lukewaite/panasonic-intellibalance-esphome/pcb.jpg

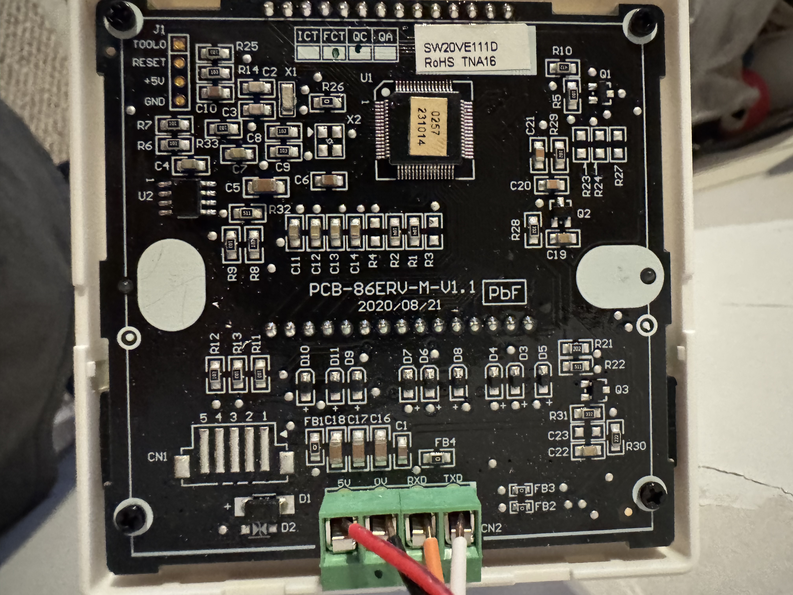
pcb.jpg
