lukewaite/panasonic-intellibalance-esphome/README.md

# Panasonic Intelli-Balance 200 ↔ ESPHome

Home Assistant control of a **Panasonic Intelli-Balance 200 ERV**, in the spirit of ratgdo. A small
ESP32-C6 board sits inline on the 4-wire cable between the ERV and its FV-SW20VEC1 wall control and
runs ESPHome over Thread. The wall control keeps working as before.

What it does:

- **Shows** power, airflow, ASHRAE setting, boost, the ventilation rest cycle, and inside/outside
  temperature and humidity.
- **Controls** power, a 60 min boost, supply/exhaust airflow and the ASHRAE run time.
- **Turns the ERV back on after a power failure**, which the ERV doesn't do by itself.
- **Fails safe:** unpowered or crashed, the board passes the link straight through.

## Install

A device config only names the device and sets up its network; the package brings in the rest:

```yaml
substitutions:
  name: ervlink
  friendly_name: ERV link
packages:
  ervlink: github://lukewaite/panasonic-intellibalance-esphome/firmware/ervlink-package.yaml@main
esphome:
  name: ${name}
  friendly_name: ${friendly_name}
api:
  encryption:
    key: !secret ervlink_api_key
wifi:                       # or Thread: see firmware/ervlink.yaml
  ssid: !secret wifi_ssid
  password: !secret wifi_password
```

`@main` follows the latest release (ESPHome refreshes it daily, and `main` always loads the
core at its latest release tag). To stay on one version, use a tag instead: `@fw-v16`.

## What's here

| | |
|---|---|
| [`firmware/ervlink-package.yaml`](firmware/ervlink-package.yaml) | The ESPHome package: the whole board, pulled in by a short device config. |
| [`firmware/ervlink.yaml`](firmware/ervlink.yaml), [`example-wifi.yaml`](firmware/example-wifi.yaml) | Device configs for Thread or Wi-Fi. Paste one into the ESPHome Device Builder, set the name and secrets. |
| [`hardware/DESIGN.md`](hardware/DESIGN.md) | The board: how it works and why each part was chosen. |
| [`hardware/kicad/`](hardware/kicad/) | KiCad project (generated by the scripts in `gen/`), with a [schematic PDF](hardware/kicad/ervlink-schematic.pdf) and JLCPCB gerbers, BOM and placement in [`fab/`](hardware/kicad/fab/). |
| [`hardware/bom-digikey.csv`](hardware/bom-digikey.csv) | The hand-soldered parts, enclosure and standoffs. |
| [`hardware/STATUS.md`](hardware/STATUS.md) | Build notes and a bring-up checklist. |
| [`docs/firmware.md`](docs/firmware.md) | How the board takes over the link, and how it resumes after a power cut. |
| [`docs/protocol.md`](docs/protocol.md) | How the ERV and wall control talk, and how to decode a capture. |
