lukewaite/panasonic-intellibalance-esphome/captures/TEMPLATE-notes.md

# Capture YYYY-MM-DD — <one-line purpose, e.g. "supply airflow staircase">

Copy this to `captures/YYYY-MM-DD/YYYY-MM-DD-notes.md` and fill it in *while capturing*.
The single most valuable thing here is the action log with real elapsed times.

## Sensor readings on the display at capture time

Press In/Out as needed to read all four. Record all of them even if the capture isn't about
sensors — these are what let us pin down register `B1`.

| | temp | humidity |
|---|---|---|
| Inside  |  °F |  %RH |
| Outside |  °F |  %RH |

Other displayed values: supply ___ cfm, exhaust ___ cfm, ASHRAE ___

## Unit state

- Unit on/off at start of capture:
- Was the ERV mains-power-cycled for this capture? (not required — see README):
- Boost active:

## Action log

Elapsed seconds from the start of the Saleae recording. **Do not estimate by counting in your
head** — watch the Saleae timer or a stopwatch started with the recording. The first capture's
notes were off by ~4 s, which cost real effort to reconcile.

| t (s) | action | display after |
|---|---|---|
|  |  |  |
|  |  |  |
|  |  |  |
|  |  |  |
|  |  |  |

## Capture settings used

- Analog sample rate:
- Channels (which probe on which wire):
- Duration:

## Notes / anything unexpected
