lukewaite/panasonic-intellibalance-esphome/captures/2026-10-29/2026-10-29-notes.md

# Capture 2026-10-29 — button session through the rev A board (listen-only firmware)

No Saleae recording. The rev A board decoded both lines live (firmware v2, 0 bad frames) and
Home Assistant's recorder logged every register change with millisecond timestamps
(`sensor.erv_link_rxd_*` / `sensor.erv_link_txd_*`, ~10 days retention). Times below are local
(EDT) wall clock from that history; the operator reported each step in chat as it was done.
Values are raw register strings as sent (low nibble first, see docs/protocol.md "Registers").

## Sensor readings on the display

| time | outside | `B1` |
|---|---|---|
| 21:47 (photo) | 59 °F / 75 %RH | `3103F0B4` → in 19 °C 48 %, out 15 °C 75 % |
| 22:11 | 57 °F / 76 %RH | `3103E0C4` → in 19 °C 48 %, out 14 °C 76 % |

Inside, via In/Out, read later that evening: 66 °F / 48 %RH, with `B1` inside bytes 19 °C / 48 %.
Airflow menu steps are 20 CFM (60–200); ASHRAE steps are 10 min/h.

Other displayed values at start: supply 120 cfm, exhaust 120 cfm, ASHRAE 30 min/h.

## Unit state

- On at start, no boost. No mains power cycle.

## Action log

| time | action | RXD command(s) | TXD state change |
|---|---|---|---|
| 22:08:38 | supply 120 → 140 | `00` `FF90FF00`, then `FFFF7000` | `01` `10707000` → `10907000` |
| 22:09:36 | supply 140 → 120 | `00` `FF70FF00` | `01` → `10707000` |
| 22:09:41 | exhaust 120 → 140 | `00` `FFFF9000` | `01` → `10709000` |
| 22:10:23 | exhaust 140 → 120 | `00` `FF70FF00`, then `FFFF7000` | `01` → `10707000` |
| 22:10:50 | Boost; display "Boost on 60m", then 200/200 cfm | `00` `10FFFF00`, `10` `30600000`, `20` `10000000` | `01` → `10010100`, `11` → `30600000`, `21` → `10000000` |
| ~22:11:40 | (display counting down, 59m) | — | no change |
| 22:12:11 | Boost cancelled; back to 120/120 | `00` `10707000`, `10` `30600000`, `20` `00000000` | `01` → `10707000`, `11` → `30000000`, `21` → `00000000` |
| ~22:12:50 | Vent pressed (opens airflow editor, supply flashing) | — | — |
| 22:13:30 | supply → 200 (max), exhaust unchanged | `00` `FF01FF00`, then `FFFF7000` | `01` → `10017000` |
| 22:14:09 | supply 200 → 180 (one step down) | `00` `FFD0FF00`, `FFD07000`, `FFFF7000` | `01` → `10D07000` |
| 22:14:49 | ASHRAE 30 → 10 | `10` `10FF0000` | `11` → `10000000` |
| 22:15:25 | supply 180 → 120 | (not pulled) | `01` → `10707000` |
| 22:15:33 | ASHRAE 10 → 30 | (not pulled) | `11` → `30000000` |
| 22:15:51 | OFF; display shows only outside temp/RH | `00` `00707000`, `10` `30FF0000`, `20` `00000000` | `01` → `00000000`, `11` → `00000000` |
| 22:16:29 | ON; 120/120, ASHRAE 30 | `00` `10707000`, `10` `30FF0000`, `20` `00000000` | `01` → `10707000`, `11` → `30000000` |
| ~22:17 | Filter, short press; no visible change | — | — |
| 22:18:21 | supply 120 → 60 (menu minimum), one save | `00` `FF10FF00` | `01` → `10107000` |
| ~22:19 | supply 60 → 120 | | |
| 22:36:22 | Boost, 60 m, left to time out | `00` `10FFFF00`, `10` `30600000`, `20` `10000000` | `01` → `10010100`, `11` → `30600000`, `21` → `10000000` |
| 23:36:24 | Boost timed out (60 min 2 s); display back to 120/120 | **none** | `11` → `30000000`, `21` → `00000000` (24.59), `01` → `10707000` (24.74) |

The timeout came entirely from the ERV: no RXD command, and the ERV restored the pre-boost
airflow itself. `30`, `F0`, `31`, `A1` and `F1` (`00003E00`) never changed. 0 bad frames, no unexpected
registers throughout.

## Capture settings used

- rev A board 1, SW1 not fitted (passthrough only), firmware `firmware/ervlink.yaml` v2.
