lukewaite/panasonic-intellibalance-esphome/captures/2026-11-02/2026-11-02-notes.md

# 2026-11-02 — power-failure resume (firmware v10)

No logic analyzer. Times from Home Assistant history (board on its own USB brick, so it stayed
up through the outage).

| time | event |
|---|---|
| ~19:16:29 | ERV mains off (user). Both frame rates fall to 0 by 19:16:39/44. v10 left Power, airflow etc. at their last values (fixed in v11). |
| ~19:18:02 | ERV mains back on. |
| 19:18:02.49 | First `01` from the ERV: off (Power switch off, airflow unknown). |
| 19:18:12.49 | Resume: relay in, ~10 s after the wall control's `FFFFFFFF` burst armed it. |
| 19:18:12.86 | ERV reports on at the saved settings (100/100 CFM), 0.37 s after relay in. |
| 19:18:13.50 | Relay out. |

Result: **the ERV turned itself back on ~10.4 s after mains returned**, first try, with the
pre-outage airflow.
