lukewaite/panasonic-intellibalance-esphome/captures/2026-10-30/2026-10-30-notes.md

# 2026-10-30 — first intercept and remote turn-on (firmware v5)

No Saleae recording. Times are local (EDT) from Home Assistant history. Board 1, SW1 in AUTO,
firmware `firmware/ervlink.yaml` v5. The ERV had been off since 08:43 (left off to test the
"ERV off for 10 minutes" notification, which fired at 08:53:26).

## Action log

| time | action | result |
|---|---|---|
| 10:01:56.316 | HA: **Intercept test** pressed | relay in 56.521 (205 ms after the press, in a shared gap), out 57.138 (617 ms in). Board forwarded the panel's idle frames for 3 cycles. ERV stayed off, wall control carried on as normal. |
| 10:02:08.321 | HA: **Turn on** pressed | relay in 08.528 (207 ms), TXD `01` `00000000` → `10707000` at 08.826 (298 ms after relay in, 505 ms after the press), relay out 09.541 (1.01 s in: 3 command + 2 idle cycles). Power on in HA, ERV running 120/120. |

Operator confirmed both: relay clicked, nothing disturbed on the test, ERV started on Turn on.

- The RXD tap is on the panel side, so `sensor.erv_link_rxd_00` stayed `FFFFFF00` throughout:
  the injected `10707000` is visible only in its effect on TXD `01`.
- The wall control picked the new state up from TXD with no command of its own; it is a pure
  display of `01`/`11`/`21`.
- The ERV applied the command 0.3 s after the first injected frame, as the panel's own presses
  (0.2–0.4 s).
- No analog capture of the board's drive levels was taken first; the ERV accepted the board's
  RXD drive (1k pull-up to ~4.7 V through Q2) as is.

## ASHRAE rest (firmware v6)

| time | action | result |
|---|---|---|
| 12:08:52.98 | HA: ASHRAE select 60 → 30 min/h | relay in, `11` → `30000000` at 53.55 (0.57 s), relay out 53.97 |
| 12:38:53.95 | (none) | `01` → `10EFEF00`: still on, supply and exhaust code `FE`. Exactly 30 min after the ASHRAE change: the rest half of the 30 min/h cycle. |
| 13:08:55.42 | (none) | `01` → `10707000`: air moving again, 30 min 1.5 s into the rest. v7's Ventilating went on at the same instant. |

v6 showed airflow as unknown during the rest; v7 shows 0 CFM, adds "Ventilating", and hides
B1 while resting.

## Boost switch (firmware v8)

| time | action | result |
|---|---|---|
| 20:38:21 | HA: Boost switch on (dashboard) | `01` supply 200 CFM and boost duration 60 at 21.79, `21` boost on at 21.89, relay out 22.43 |
| 21:38:24.71 | (none) | Boost over (60 min 3 s): switch off by itself, supply 120 at 24.88 |
| 22:08:26.22 | (none) | ASHRAE rest (0 CFM), 30 min after the boost ended |
| 22:38:27.71 | (none) | Air moving again; 30/30 cycle continues through the night |

First boost sent by the board. It was started 3 min into an ASHRAE rest (20:35:19): boost
overrides the rest, and **ending a boost restarts the ASHRAE cycle** with a full run period.
