lukewaite/panasonic-intellibalance-esphome/captures/2025-12-14/2025-12-14-notes.md

Approx timestamps (me counting in my head)
0s -> current state is ERV is off
5s power on to erv
10s push on/off on panel
15s stop capture

current values displayed
80 cfm supply
80 cfm exhaust
20 ashrae

outside humidity 85%RH 
outside temp 37F
