lukewaite/panasonic-intellibalance-esphome/hardware/bom-digikey.csv

Quantity per board | Manufacturer Part Number | Manufacturer | DigiKey Part Number | Reference | Description | Notes
1 | G6S-2 DC5 | Omron/Aratas | Z2615-ND | K1 | DPDT signal relay 5V THT 28mA | Matches the Relay_DPDT_Omron_G6S-2 footprint
1 | OS102011MS2QN1 | C&K | CKN9565-ND | SW1 | SPDT slide switch THT vertical | Must be MS2Q (vertical), not MA1Q (right-angle). Order by DigiKey number: the MPN matches two listings
2 | 1715747 | Phoenix Contact | 277-1265-ND | J1,J2 | 4-pos 5.08mm screw terminal (MKDS 1.5/4-5.08) | Generic 5.08mm KF128-style blocks also fit
0.2 | PRPC040SAAN-RC | Sullins | S1011EC-40-ND | J3 | 1x40 breakaway male header 2.54mm | One strip covers 5 boards (8 pins each)
1 | 1591CSBK | Hammond | HM104-ND | enclosure | ABS box 120x65x40 with lid | 1591CSGY is the grey version
5 | 25511 | Keystone | 36-25511-ND | H1-H5 | M3 x 12 mm nylon hex standoff female-female | 12 mm maximum (lid clearance); use M3 x 6-8 mm screws
