lukewaite/panasonic-intellibalance-esphome/hardware/kicad/fab/ervlink-bom.csv

Comment | Designator | Footprint | LCSC Part #
100k | R3,R4,R5,R10,R11,R17,R23 | R_0805_2012Metric | C149504
10µF | C5,C7,C9 | C_0805_2012Metric | C15850
USB-C | J4 | USB_C_Receptacle_HRO_TYPE-C-31-M-12 | C165948
100 | R2,R16,R22 | R_0805_2012Metric | C17408
10k | R9,R13,R15,R26,R27 | R_0805_2012Metric | C17414
12k | R7 | R_0805_2012Metric | C17444
1k | R1,R18,R30 | R_0805_2012Metric | C17513
2.2k | R24 | R_0805_2012Metric | C17520
220k | R8,R14 | R_0805_2012Metric | C17556
22k | R6 | R_0805_2012Metric | C17560
51k | R12 | R_0805_2012Metric | C17737
100pF | C1,C2 | C_0805_2012Metric | C1790
AO3400A | Q1,Q2,Q3 | SOT-23 | C20917
INTERCEPT | LED2 | LED_0805_2012Metric | C2296
POWER | LED1 | LED_0805_2012Metric | C2297
SS14 | D6 | D_SMA | C2480
5.1k | R28,R29 | R_0805_2012Metric | C27834
1µF | C4 | C_0805_2012Metric | C28323
22µF | C8 | C_0805_2012Metric | C45783
100nF | C3,C6 | C_0805_2012Metric | C49678
ESP32-C6-WROOM-1-N8 | U1 | ESP32-C6-WROOM-1 | C5366877
AMS1117-3.3 | U3 | SOT-223-3_TabPin2 | C6186
LM393DR2G | U2 | SOIC-8_3.9x4.9mm_P1.27mm | C7955
1N4148W | D1 | D_SOD-123 | C81598
