lukewaite/panasonic-intellibalance-esphome/hardware/kicad/ervlink-schematic.pdf

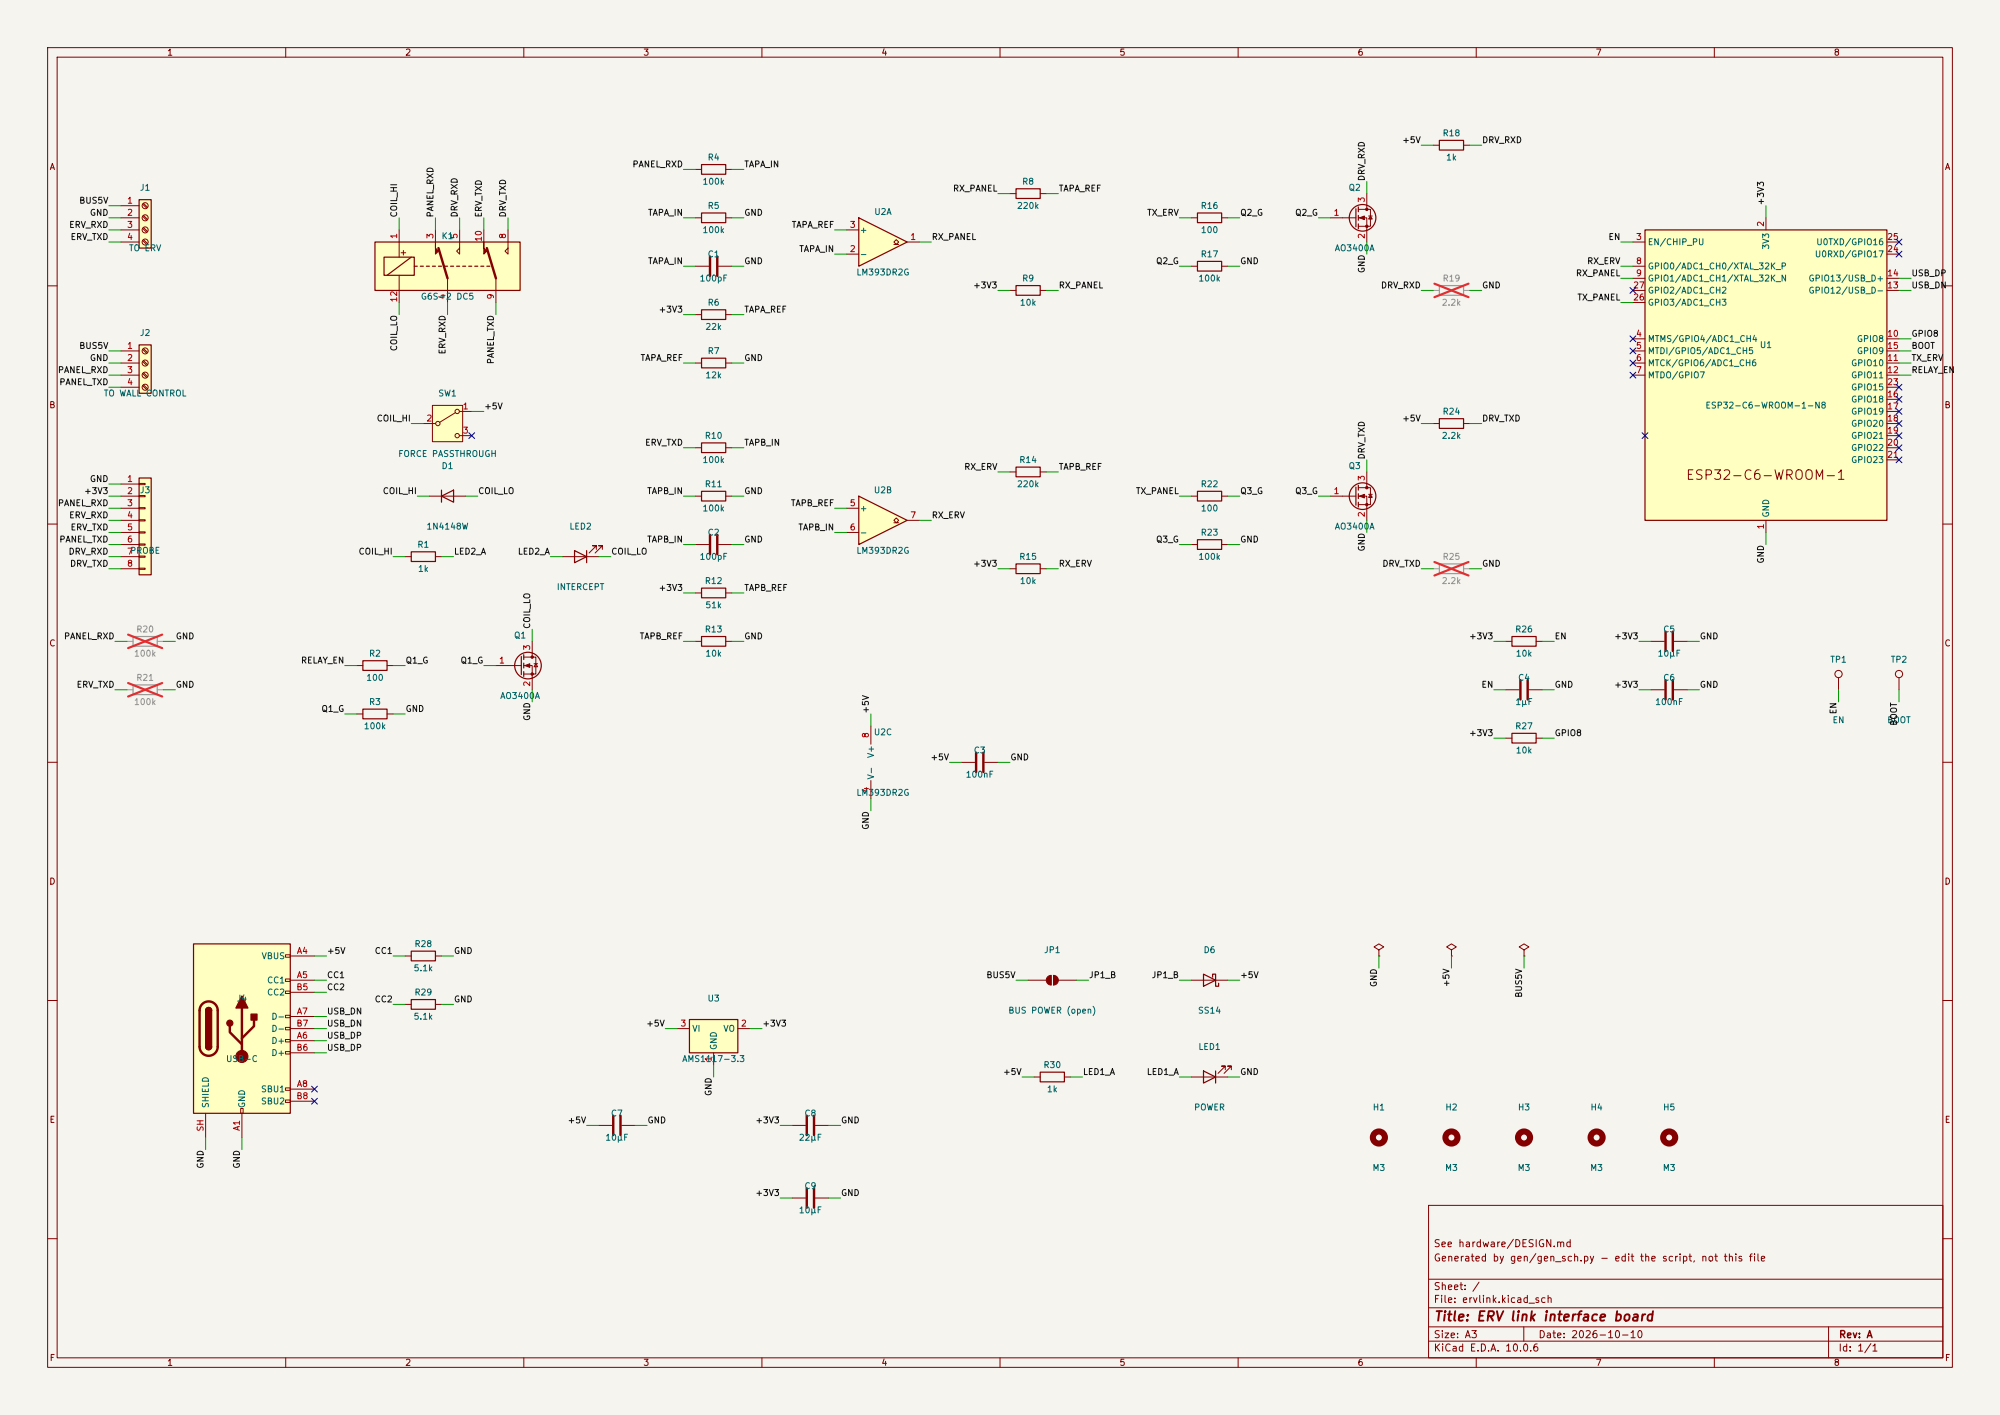
[picture p2: page 1]

See hardware/DESIGN.md
Generated by gen/gen_sch.py - edit the script, not this file

Sheet: /
File: ervlink.kicad_sch
Title: ERV link interface board

Size: A3 | Rev: A | F Date: 2026-10-10
KiCad E.D.A. 10.0.6 | Id: 1/1
