lukewaite/panasonic-intellibalance-esphome/hardware/kicad/ervlink.kicad_pcb

## KiCad design hardware/kicad/ervlink.kicad_pcb (2026-11-03)

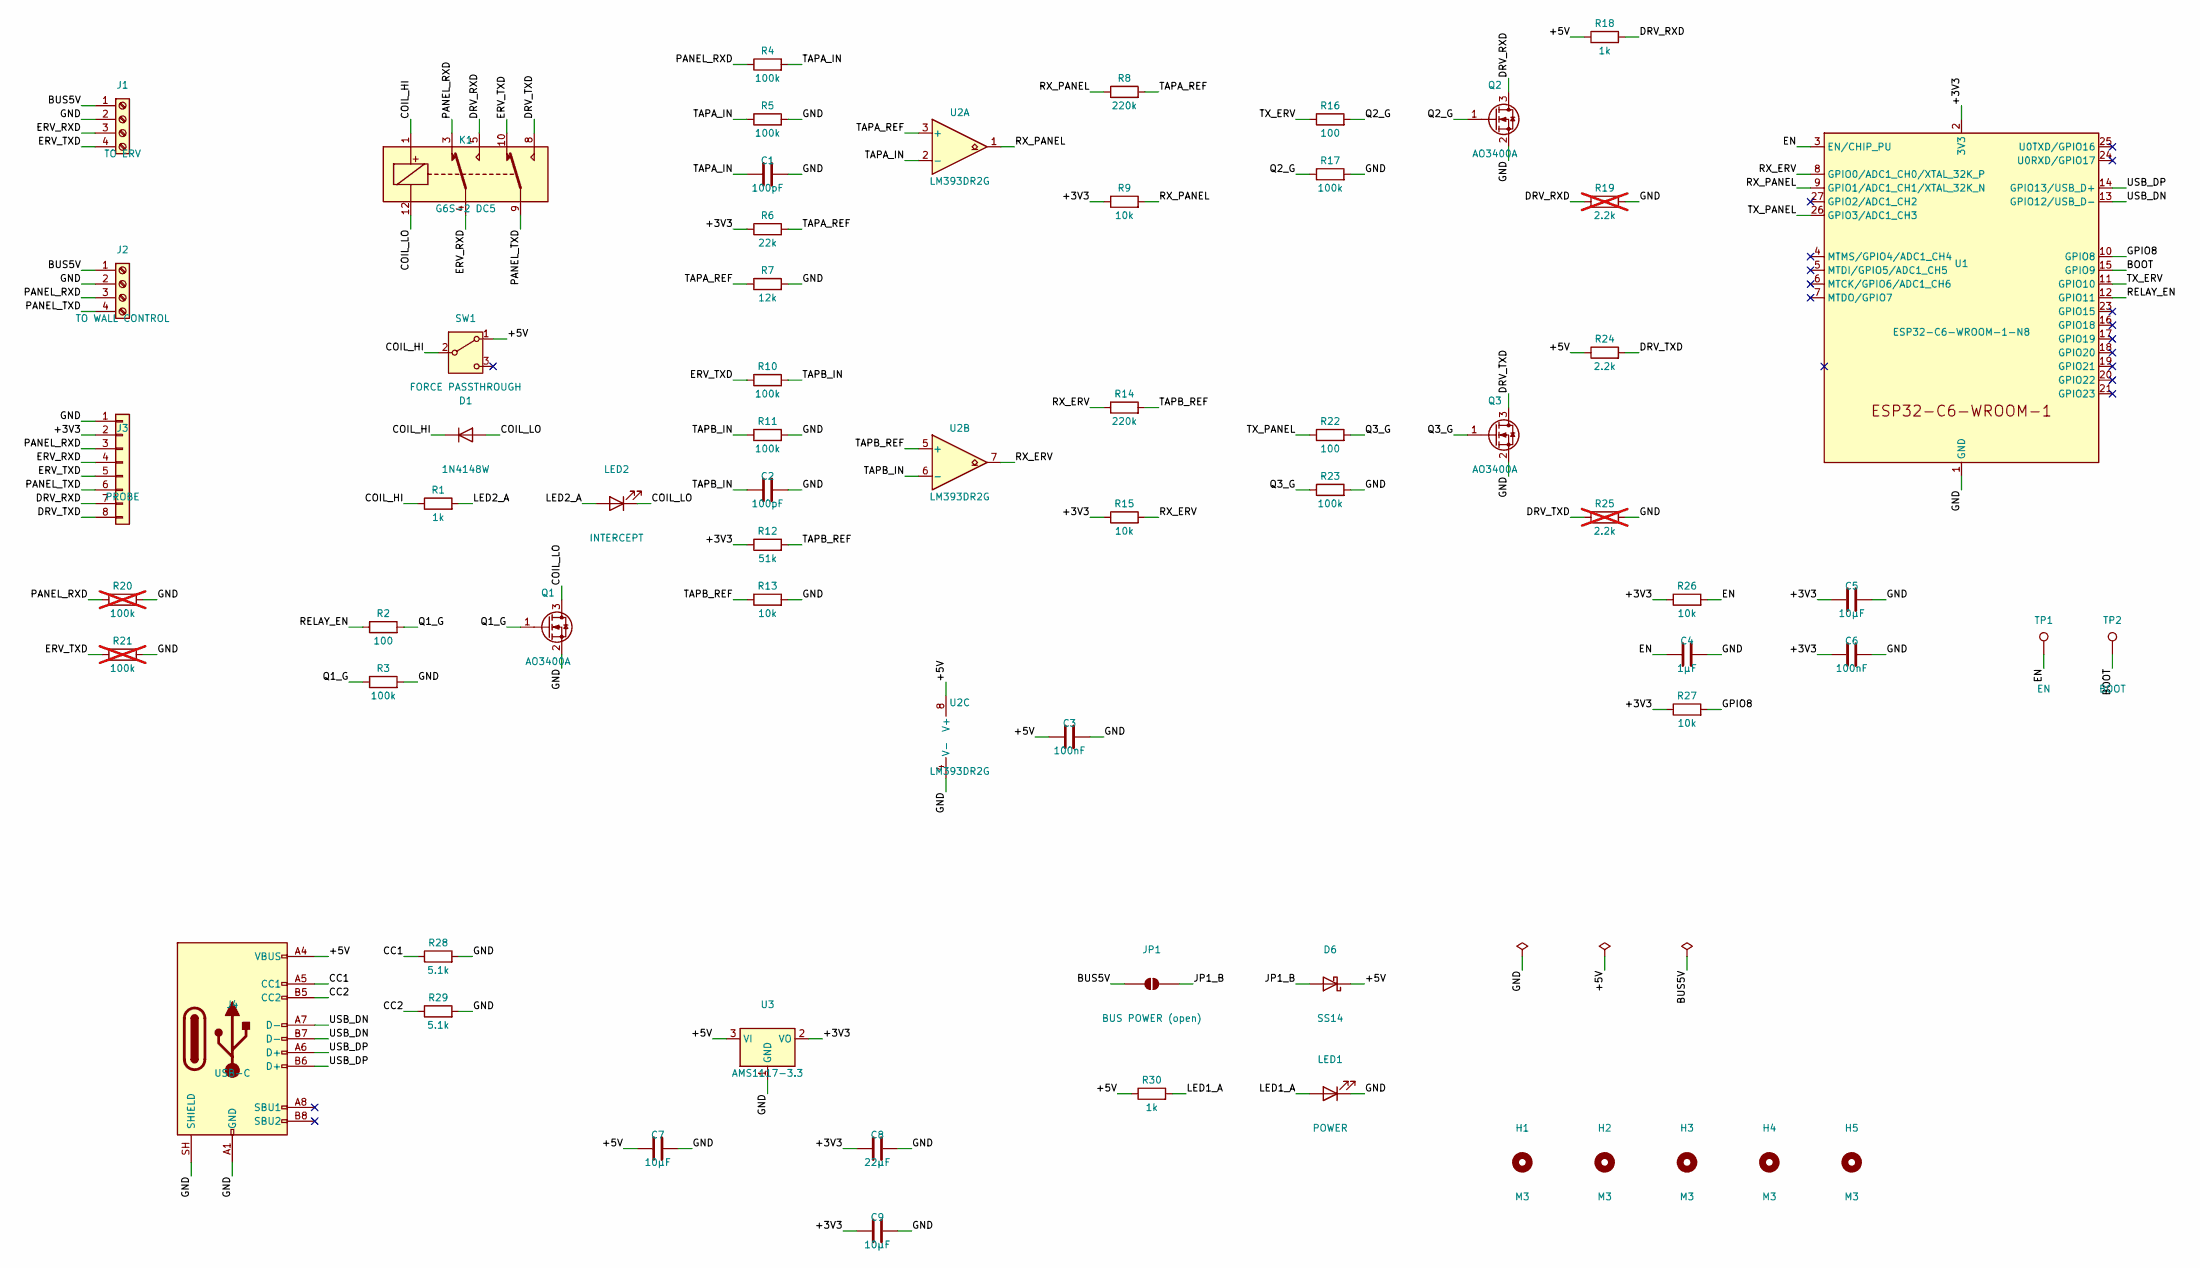
[picture p3: schematic ervlink.kicad_sch, ERV link interface board]

Parts:
C1, C2: 100pF; C_0805_2012Metric; LCSC C1790
C3, C6: 100nF; C_0805_2012Metric; LCSC C49678
C4: 1µF; C_0805_2012Metric; LCSC C28323
C5, C7, C9: 10µF; C_0805_2012Metric; LCSC C15850
C8: 22µF; C_0805_2012Metric; LCSC C45783
D1: 1N4148W; D_SOD-123; LCSC C81598
D6: SS14; D_SMA; LCSC C2480
H1, H2, H3, H4, H5: M3; MountingHole_3.2mm_M3
J1: TO ERV; TerminalBlock_Phoenix_MKDS-1,5-4-5.08_1x04_P5.08mm_Horizont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
J2: TO WALL CONTROL; TerminalBlock_Phoenix_MKDS-1,5-4-5.08_1x04_P5.08mm_Horizont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
J3: PROBE; PinHeader_1x08_P2.54mm_Vertical
J4: USB-C; USB_C_Receptacle_HRO_TYPE-C-31-M-12; LCSC C165948
JP1: BUS POWER (open); SolderJumper-2_P1.3mm_Open_RoundedPad1.0x1.5mm
K1: G6S-2 DC5; Relay_DPDT_Omron_G6S-2
LED1: POWER; LED_0805_2012Metric; LCSC C2297
LED2: INTERCEPT; LED_0805_2012Metric; LCSC C2296
Q1, Q2, Q3: AO3400A; SOT-23; LCSC C20917
R1, R18, R30: 1k; R_0805_2012Metric; LCSC C17513
R2, R16, R22: 100; R_0805_2012Metric; LCSC C17408
R3, R4, R5, R10, R11, R17, R23: 100k; R_0805_2012Metric; LCSC C149504
R6: 22k; R_0805_2012Metric; LCSC C17560
R7: 12k; R_0805_2012Metric; LCSC C17444
R8, R14: 220k; R_0805_2012Metric; LCSC C17556
R9, R13, R15, R26, R27: 10k; R_0805_2012Metric; LCSC C17414
R12: 51k; R_0805_2012Metric; LCSC C17737
R19, R25: 2.2k; R_0805_2012Metric; not fitted
R20, R21: 100k; R_0805_2012Metric; not fitted
R24: 2.2k; R_0805_2012Metric; LCSC C17520
R28, R29: 5.1k; R_0805_2012Metric; LCSC C27834
SW1: FORCE PASSTHROUGH; SW_Slide_SPDT_Straight_CK_OS102011MS2Q
TP1: EN; TestPoint_Pad_D1.5mm
TP2: BOOT; TestPoint_Pad_D1.5mm
U1: ESP32-C6-WROOM-1-N8; ESP32-C6-WROOM-1; LCSC C5366877
U2: LM393DR2G; SOIC-8_3.9x4.9mm_P1.27mm; LCSC C7955
U3: AMS1117-3.3; SOT-223-3_TabPin2; LCSC C6186

Connections:
/+3V3: C5.1, C6.1, C8.1, C9.1, J3.2, R6.1, R9.1, R12.1, R15.1, R26.1, R27.1, U1.2 (3V3), U3.2 (VO)
/+5V: C3.1, C7.1, D6.1 (K), J4.A4 (VBUS), J4.A9 (VBUS), J4.B4 (VBUS), J4.B9 (VBUS), R18.1, R24.1, R30.1, SW1.1 (A), U2.8 (V+), U3.3 (VI)
/BOOT: TP2.1, U1.15 (GPIO9)
/BUS5V: J1.1, J2.1, JP1.1 (A)
/CC1: J4.A5 (CC1), R28.1
/CC2: J4.B5 (CC2), R29.1
/COIL_HI: D1.1 (K), K1.1, R1.1, SW1.2 (B)
/COIL_LO: D1.2 (A), K1.12, LED2.1 (K), Q1.3 (D)
/DRV_RXD: J3.7, K1.5, Q2.3 (D), R18.2, R19.1
/DRV_TXD: J3.8, K1.8, Q3.3 (D), R24.2, R25.1
/EN: C4.1, R26.2, TP1.1, U1.3 (EN/CHIP_PU)
/ERV_RXD: J1.3, J3.4, K1.4
/ERV_TXD: J1.4, J3.5, K1.10, R10.1, R21.1
/GND: C1.2, C2.2, C3.2, C4.2, C5.2, C6.2, C7.2, C8.2, C9.2, J1.2, J2.2, J3.1, J4.A1 (GND), J4.A12 (GND), J4.B1 (GND), J4.B12 (GND), J4.SH (SHIELD), LED1.1 (K), Q1.2 (S), Q2.2 (S), Q3.2 (S), R3.2, R5.2, R7.2, R11.2, R13.2, R17.2, R19.2, R20.2, R21.2, R23.2, R25.2, R28.2, R29.2, U1.1 (GND), U1.28 (GND), U1.29 (GND), U2.4 (V-), U3.1 (GND)
/GPIO8: R27.2, U1.10 (GPIO8)
/JP1_B: D6.2 (A), JP1.2 (B)
/LED1_A: LED1.2 (A), R30.2
/LED2_A: LED2.2 (A), R1.2
/PANEL_RXD: J2.3, J3.3, K1.3, R4.1, R20.1
/PANEL_TXD: J2.4, J3.6, K1.9
/Q1_G: Q1.1 (G), R2.2, R3.1
/Q2_G: Q2.1 (G), R16.2, R17.1
/Q3_G: Q3.1 (G), R22.2, R23.1
/RELAY_EN: R2.1, U1.12 (GPIO11)
/RX_ERV: R14.1, R15.2, U1.8 (GPIO0/ADC1_CH0/XTAL_32K_P), U2.7
/RX_PANEL: R8.1, R9.2, U1.9 (GPIO1/ADC1_CH1/XTAL_32K_N), U2.1
/TAPA_IN: C1.1, R4.2, R5.1, U2.2 (-)
/TAPA_REF: R6.2, R7.1, R8.2, U2.3 (+)
/TAPB_IN: C2.1, R10.2, R11.1, U2.6 (-)
/TAPB_REF: R12.2, R13.1, R14.2, U2.5 (+)
/TX_ERV: R16.1, U1.11 (GPIO10)
/TX_PANEL: R22.1, U1.26 (GPIO3/ADC1_CH3)
/USB_DN: J4.A7 (D-), J4.B7 (D-), U1.13 (GPIO12/USB_D-)
/USB_DP: J4.A6 (D+), J4.B6 (D+), U1.14 (GPIO13/USB_D+)

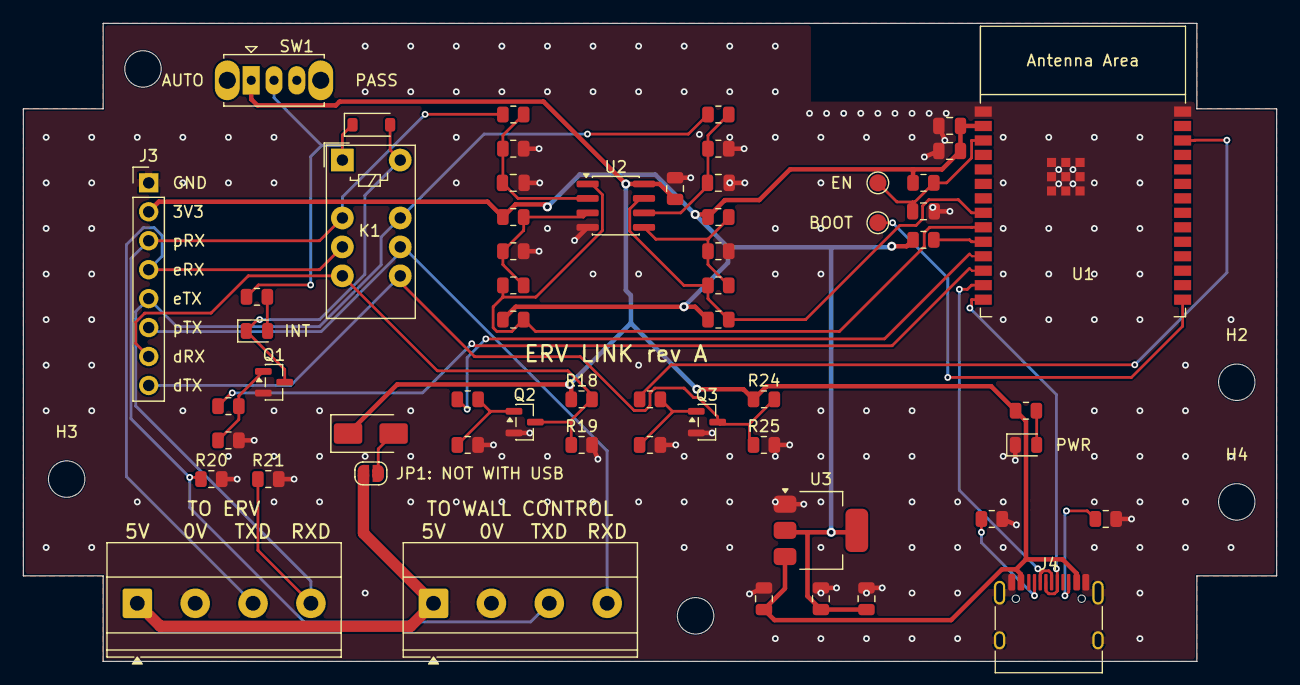
[picture p4: board ervlink.kicad_pcb from above]

Board: 2 copper layers, 110.0 x 56.0 mm, 63 parts (0 on the bottom side), 34 nets.
