lukewaite/panasonic-intellibalance-esphome/(commit log)

2026-07-26 Import prior reverse-engineering research (Dec 2025)
    Initial import of research into the low-voltage link between a Panasonic
    Intelli-Balance 200 ERV and its FV-SW20VEC1 wall control, as it stood at the
    end of the first investigation.
    Contents:
    - README.md: research log -- connector pinout, wall control PCB markings,
    button inventory, capture plan, and a first attempt at decoding the protocol.
    - pcb.jpg: wall control PCB photo (PCB-86ER-U-M-V1.1, sticker SW20VE111D).
    - captures/2025-12-14/: logic analyzer capture of ERV mains power-on followed
    by an On/Off button press, with an operator log.
    Note on the capture files: `Session 0.sal` is the archival ground truth and
    holds the full raw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
    [digital.csv]
2026-07-26 Decode the wall control protocol
    Re-derives the link from the analog capture and gets a complete, verified
    decode. The previous attempt failed because two Saleae threshold choices were
    off, which cascaded into a wrong baud rate, wrong polarity and wrong framing.
    Physical layer: 4800 baud, 8 data bits, even parity, 1 stop bit -- and
    INVERTED, so the line idles at 0 V and the start bit is a rising edge. A
    non-inverted decode yields garbage, which is what the old notes recorded. The
    RXD line swings 0-4.7 V, the TXD line only 0-2.3 V. Edges are RC-limited
    (~80 us slew on a 208 us bit), so thresholds must sit at true mid-swing or the
    resulting duty-cycle skew corrupts the sampling points.
    Frame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
    [edges-rxd.csv, edges-txd.csv]
2026-07-26 Rewrite README to match the verified decode
    The README still documented the failed first attempt as though it were current
    knowledge -- wrong baud rate, wrong polarity, wrong framing, and meaningless
    byte streams -- which made it actively misleading to anyone landing on the repo.
    Restructures it around the verified protocol: physical layer, frame format,
    BCC with a worked example, how direction was established, and link timing.
    Adds usage for tools/decode.py, the register map so far, and a concrete capture
    campaign for the semantics that are still unknown.
    Hypotheses are now fenced off in their own section and labelled as speculation.
    The sensor-register guess rests on a single matching by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
2026-07-26 Measure decoder thresholds from the capture instead of hardcoding them
    The hardcoded per-channel voltage thresholds were the one genuinely fragile
    part of the decoder: they were hand-picked for the 2025-12-14 capture and would
    have needed editing for any capture taken at a different probe point. Thresholds
    are now measured from each channel's own rails (0.5%/99.5% percentiles,
    hysteresis at +/-10% of swing around mid-point), and CSV columns are matched by
    Saleae channel name rather than fixed position. A fresh capture needs no code
    changes.
    Verified: auto-derived thresholds reproduce the previously verified decode
    exactly -- same 596 frames, all BCC valid, identical address and payload
    sequ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
    [edges-rxd.csv, edges-txd.csv]
2026-07-26 Add a capture notes template
    The existing capture log was timed by counting in the operator's head and was
    off by ~4 s, which took real effort to reconcile against the data. The template
    makes the action log explicit and asks for all four sensor readings every time,
    since those are what pin down register B1.
    Claude-Session: https://claude.ai/code/session_018P286nt1NaPUvsamRtEg3i
2026-10-10 Add rev A inline interface board (ESP32-C6, KiCad 10)
    An ESP32-C6-WROOM-1 board that sits in the ERV <-> wall control link:
    relay passthrough at rest, comparator taps on both lines, open-drain
    drivers for intercept mode. USB-C powered, 85x60 mm, 2 layers.
    The schematic and PCB are generated by hardware/kicad/gen/ (gen_sch.py,
    gen_pcb.py with Freerouting, gen_fab.py for JLCPCB BOM/CPL/gerbers).
    ERC and DRC are clean and the board matches the schematic. Design
    rationale, values and bring-up plan are in hardware/DESIGN.md.
    Not yet bench-validated.
    [bom-digikey.csv, ervlink-bom.csv, ervlink.kicad_pcb, ervlink.kicad_sch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]
2026-10-10 Resize board for a Hammond 1591C and apply verification fixes
    110 x 56 mm with corner notches for the box's lid bosses; no tracks or
    vias under mounting holes; full-body module track keep-out; two vias per
    pour island. ERC/DRC clean (only J1/J2/J4 silk clipped at the edge).
    [ervlink.kicad_pcb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]
2026-10-10 Add Hammond 1591C enclosure and drilling guide to DESIGN.md
2026-10-10 Apply final review: USB-C reach, fifth mounting hole, panel and box notes
    J4 moves 0.5 mm out so a cable reaches through the 1591C wall; H5 supports
    the terminal edge. DESIGN.md: tab-routed rails on the short edges only,
    12 mm maximum standoffs, antenna height, H5 floor hole, larger USB slot.
    ERC/DRC clean (4 cosmetic silk-at-edge warnings).
    [ervlink.kicad_pcb, ervlink.kicad_sch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]
2026-10-11 Correct JLCPCB placement rotations and offsets from their preview
    U2 +270, U3 and Q1-Q3 +180, J4 shifted 1.4 mm inward; drop the U1 body-centre
    offset, since JLCPCB already places the module by its pad-grid centre.
    [ervlink-cpl.csv]
2026-10-11 Record rev A orders and the arrival checklist
    hardware/STATUS.md lists the JLCPCB and DigiKey orders, what's not done
    yet, and the arrival and bring-up checklist. CLAUDE.md points there first.
    DESIGN.md bring-up reordered to start with an unpowered capture; the
    DigiKey BOM gains part numbers, the box and standoffs.
    [bom-digikey.csv]
2026-10-30 Add listen-only ESPHome firmware and record rev A bring-up
    firmware/ervlink.yaml reads both lines through the comparator taps
    (4800 8E1), checks STX/ETX/hex/BCC, publishes each register to Home
    Assistant over Thread, and holds the relay off. Bring-up on the ERV:
    25.0 and 19.0 frames/s with zero bad frames.
    The ERV's and wall control's TXD terminal carries the commands, the
    reverse of this repo's line names, so J1/J2 must be wired crossed.
    CLAUDE.md and STATUS.md record that, the blank-module boot loop, and
    the bring-up result.
    Claude-Session: https://claude.ai/code/session_013cAk2DvfjPwzVdki2r27Np
2026-10-30 Decode power, airflow, ASHRAE and B1 sensors in firmware v2
    The data field is four bytes sent as ASCII hex, low nibble first.
    Read that way, TXD 01 is on/off plus supply and exhaust airflow
    (CFM = 50 + 10 x value), TXD 11 is ASHRAE in tens of min/h, and TXD
    B1 is inside temp, inside RH, outside temp, outside RH. The outside
    values and airflow match the wall control display on 2026-10-29 and
    the 2025-12-14 notes. Raw hex sensors stay as ground truth.
    Unexpected registers are now de-duplicated per line and address.
    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
2026-10-30 Decode boost and the full register map from a button session
    A timestamped button session through the rev A board (airflow edits,
    boost on/cancel, ASHRAE, off/on, filter, min/max airflow) maps every
    register that changes: 00/01 power + supply + exhaust, 10/11 ASHRAE +
    boost length, 20/21 boost, B1 inside/outside temp and RH. CLAUDE.md
    replaces the old hypotheses with that register map, and the session's
    command/state log is captures/2026-10-29/2026-10-29-notes.md.
    Firmware v3/v4: airflow code 16 is 200 CFM, airflow and ASHRAE read
    unavailable while the unit is off (the ERV zeroes them), new Boost and
    Boost duration entities, raw registers moved to diagnostic.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
2026-10-30 Confirm B1 inside temperature and humidity against the display
    In/Out shows inside 66 F / 48 %RH, matching B1 bytes 0-1 (19 C, 48 %).
    All four B1 fields are now confirmed.
    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
2026-10-30 Record SW1 fitted in AUTO and how its contacts switch
    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
2026-10-30 Firmware v5: Turn on and intercept test buttons, B1 hidden while off
    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
2026-10-30 Firmware v6: Power switch, Boost buttons, airflow and ASHRAE selects
    All go through the same send-only intercept as v5's Turn on, which they
    replace. While the ERV is off the selects set what Power on will send.
    B1 is now held back for 1 min after turn-on instead of 5.
    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
2026-10-30 Firmware v7: handle the ASHRAE rest (airflow code FE)
    The ERV reports supply and exhaust FE while on during the rest part of the
    ASHRAE cycle. Show 0 CFM, add a Ventilating sensor, hide B1 while no air
    moves, and keep the airflow selects on the saved settings.
    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
2026-10-30 Firmware v8: Boost is a switch instead of Boost/Stop boost buttons
    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
2026-10-31 Record the first board-sent boost
    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
2026-11-02 Firmware v9: turn the ERV back on after a power failure
    Remembers whether the ERV should be on (flash), ignoring the off it reports
    while powering up, and turns it back on when the link comes up with it off.
    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
2026-11-02 STATUS: power-failure resume is in firmware v9, untested
    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
2026-11-03 Firmware v10: resume only on a real mains power-up
    Review fixes: trigger on the wall control's FFFFFFFF burst or a power-on/
    brownout reset instead of TXD silence (OTA reboots and loop stalls no longer
    count), record an off made right after power-up, write want_on to flash at
    once, and keep waiting for the ERV's state for up to 2 min.
    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
2026-11-03 Firmware v11: report the ERV off when it goes silent; record the first outage resume
    v10 resumed the ERV 10.4 s after mains returned on the first real outage.
    During the outage it left Power and the readings frozen, so the off alert
    couldn't fire: after 10 s with no state frames v11 reports the ERV off,
    clears the readings, refuses commands, and adds an ERV connected sensor.
    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
2026-11-03 Firmware v12: review fixes for power-failure resume
    - want_on in its own preference, saved and synced on change (a restore_value
    global is only queued once a second, so the old sync() flushed nothing new)
    - clear powerup whenever the ERV is seen on, not only when 01 changes
    - learn want_on from the first state seen after an ordinary reboot
    - also arm resume when the ERV talks again after >10 s silence, in case the
    single FFFFFFFF burst frame is lost; ignore re-arms while armed
    - a resume try counts only when it starts an intercept
    - on link loss publish all TXD raw registers empty
    Claude-Session: https://claude.ai/code/session_013c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
2026-11-03 Firmware v13: detect mains power-up as the wall control booting; resume as one episode
    Review (xhigh) fixes:
    - Power-up = FFFFFFFF on any RXD register, or RXD silent >0.5 s while TXD
    runs (wall control boot). Replaces the 10 s silence and reset-reason
    triggers; a TXD tap dropout no longer arms. Reset reason only as a
    fallback when the board started listening too late to see the boot.
    - A resume is one episode that ends on success, give-up or Power off, and
    then records the ERV's real state, so a failed resume can't fire later.
    - Power off while the ERV is off/unknown cancels the resume and is remembered.
    - Tries count at relay in; episode capped at 5 min.
    - want_on is committed only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
2026-11-03 Rewrite the README for the public repo; drop superseded first-attempt material
    - README: current overview (what works, board, firmware, protocol summary,
    decoding), replacing the December 2025 research log and its hypotheses.
    Fixes the PCB marking (PCB-86ERV-M-V1.1) and J1 (4 pins incl. TOOL0).
    - CLAUDE.md: remove the superseded-claims list; the Direction section no
    longer says the terminal labels match the line names; RXD (not the ERV)
    is what goes quiet at power-up.
    - DESIGN.md: status, firmware and open items match the installed board.
    - Delete the invalid first-attempt exports (digital.csv, rxd.txt, txd.txt).
    Claude-Session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
    [digital.csv]
2026-11-03 Firmware v14: move the logic into a tested C++ component
    The interval lambda becomes ervlink::Core (firmware/components/ervlink),
    plain C++ with hooks for entities, relay, RXD driver and flash. The YAML
    loads it from this repo at tag fw-v14 and only wires it up.
    firmware/test: host tests (ASan/UBSan) with a byte-timed simulation of
    the ERV, wall control and board, plus a replay of the 2025-12-14 capture.
    26 scenarios: decoding, outages (long, short blip, lost burst), the board
    losing power with the ERV at several boot delays, board reboots, tap
    dropouts, Power off during a resume, give-up, controls, relay timing.
    Bugs the tests found, both also in v13:
    - Board and ERV losing power together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
    [ervlink_core.cpp, ervlink_core.h, sim.h, test_core.cpp]
2026-11-03 STATUS: v14 installed; the shared-outage case was broken in v13
    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
2026-11-03 CI: host tests and an ESP32-C6 compile on firmware changes
    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
2026-11-03 Firmware v15: fixes and 26 more tests from the test-gap review
    Bugs, each with a test that fails without the fix:
    - An Off within ~10 s of a resume armed while the ERV was running (a
    wall-control-only restart, or an RXD tap glitch) was undone: the
    episode only ended when 01 changed. Any "on" 01 now ends it.
    - A brownout as the relay goes in: up to an endless reboot/retry loop, or
    the reset recorded the outage's "off". A resume in progress is now
    persisted (tries made), and a reset carries it on.
    - A loop stall across a frame end made the board judge the gap from when
    it saw the frame, not when it ended, and it could switch the relay as
    the next wall control frame started. Gaps no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
    [ervlink_core.cpp, ervlink_core.h, sim.h, test_core.cpp]
2026-11-03 Board: print J1/J2 data pins with the ERV's own terminal labels
    The ERV's and wall control's terminal labels are the reverse of this repo's
    line names, so the rev A silkscreen (RXD/TXD = net names) had to be wired
    crossed. J1/J2 pin 3 (command net *_RXD) is now printed TXD and pin 4 (state
    net *_TXD) RXD, so the board wires label-to-label. Nets, schematic, firmware
    and the J3 probe labels are unchanged.
    gen_pcb.py gains --silk-only, which edits the SILK strings of the existing
    gr_text items in place: Freerouting is not deterministic, so a full run would
    reroute the copper. The .kicad_pcb diff is the four strings; the regenerated
    gerbers differ from the ordered ones only in F.Silkscreen (and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
    [ervlink.kicad_pcb]
2026-11-03 Firmware v16: ship the board as an ESPHome package
    firmware/ervlink-package.yaml holds the board (UARTs, relay, entities,
    the core's wiring) and loads the component at the same tag. A device
    config only sets the name, the API key and the network (Thread or Wi-Fi)
    and pulls the package with packages: github://...@fw-v16, like ratgdo.
    ervlink.yaml is now the author's Thread config; example-wifi.yaml the Wi-Fi
    one. The resolved config of ervlink.yaml is identical to v15's apart from
    the substitutions block, so entity IDs are unchanged. compile.sh takes a
    device config and points package and component at the checkout; CI
    compiles both configs.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
    [ervlink-package.yaml]
2026-11-03 README: point the package at @main; tags pin a version
    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
2026-11-03 Trim CLAUDE.md to a bootstrap; protocol and quirks in docs/protocol.md
    The full decode, its evidence and the surprises (reversed terminal
    labels, inverted UART, 2.3 V TXD, power-up burst, FF/FE/code 16, the
    ERV's own rest and boost timers) move to docs/protocol.md; board
    regeneration to hardware/kicad/README.md.
    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
    [ervlink_core.cpp, ervlink_core.h]
2026-11-03 docs/firmware.md: how the board intercepts and resumes
    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
